mneuhaus/EnragedRabbitProject/usermods/Binky/Images/TCRT5000.jpg

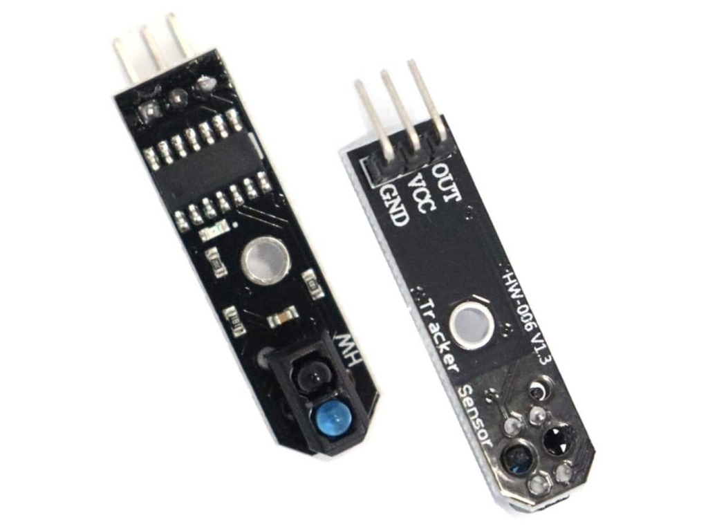
usermods/Binky/Images/TCRT5000.jpg
