mneuhaus/EnragedRabbitProject/usermods/Binky/CAD/EncoderCart - Binky.step

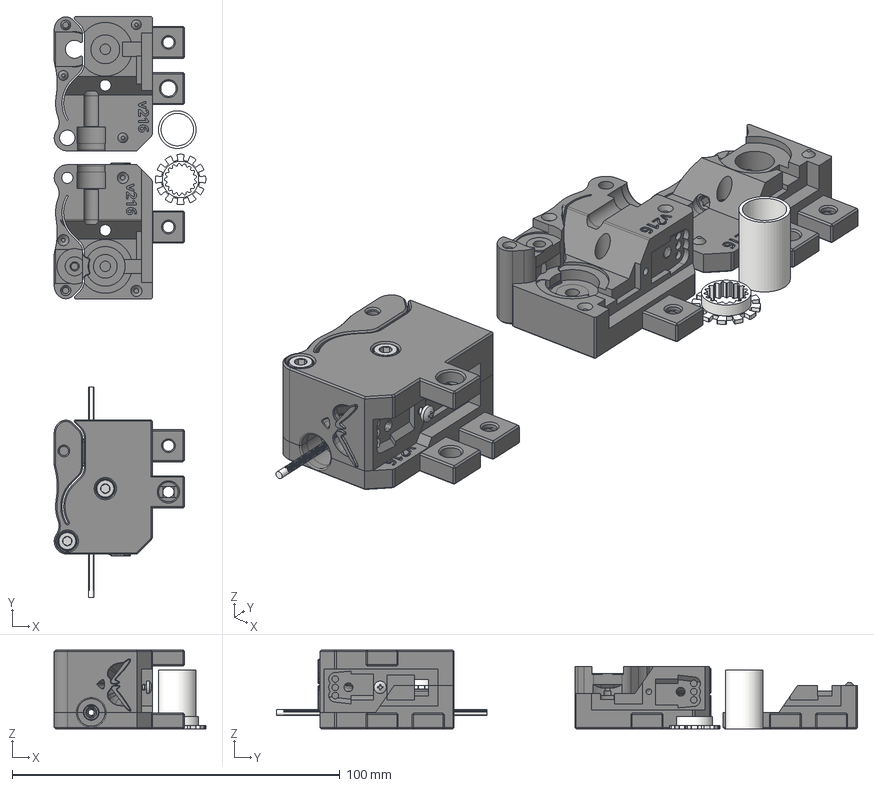
[picture p8: CAD file, 2023-09-06]
usermods/Binky/CAD/EncoderCart - Binky.step
46.2 x 177.2 x 24.0 mm
623ZZ v1
Magnet6x3 v1 (3)
Magnet6x3 v1 (1) (1)
M3x8SHCS v1 (1)
M3x16 SHCS (2)^Fan Assembly (1)_X Carriage (2) (1) x 3
M3 Threaded Insert (1)^VORON Clockwork_X Carriage x 2
stift 3 x 20 (1)^Direct_Drivegear_without_setscrew (1)_Guidler_VORON Clockwork_X Carriage (1)
K3x5x7 Needlebearing (1)^Direct_Drivegear_without_setscrew (1)_Guidle r_VORON Clockwork_X Carriage (1) x 2
Direct_Drivegear_without_setscrew (1)-39^Direct_Drivegear_without_set screw (1)_Guidler_VORON Clockwork_X Carriage (1)
Filament (1)
Encoder_Slotted_Wheel
Screw - 2x10mm - Philips Button Head
Filament
Encoder_Right x 2
Encoder_Left x 2
Encoder_SlottedWheel_PushTool
Encoder_Slotted_Wheel_1
