mneuhaus/EnragedRabbitProject/usermods/Binky/STL/Encoder_Right.stl

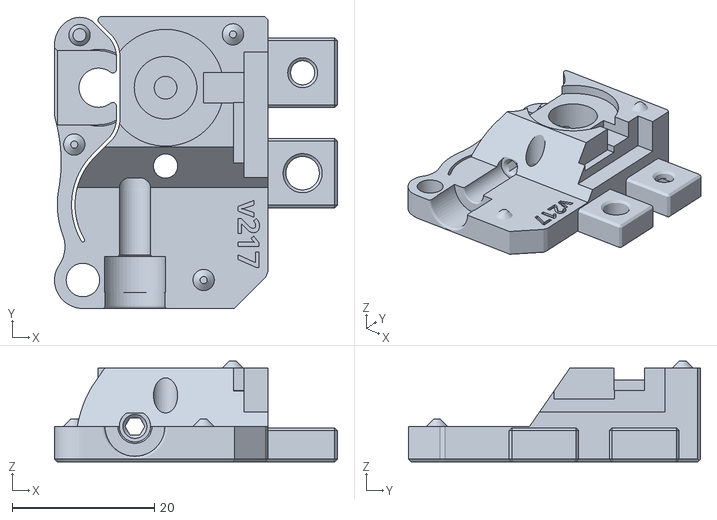
[picture p9: CAD file, 2023-09-24]
usermods/Binky/STL/Encoder_Right.stl
39.8 x 41.0 x 14.2
