mneuhaus/EnragedRabbitProject/usermods/Binky/STL/Encoder_Left.stl

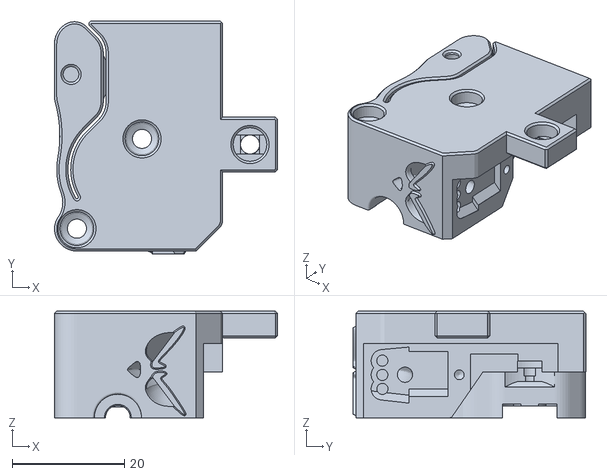
[picture p10: CAD file, 2023-07-21]
usermods/Binky/STL/Encoder_Left.stl
39.8 x 41.5 x 19.0
