mneuhaus/EnragedRabbitProject/usermods/Binky/STL/Encoder_Right_with_magnets.stl

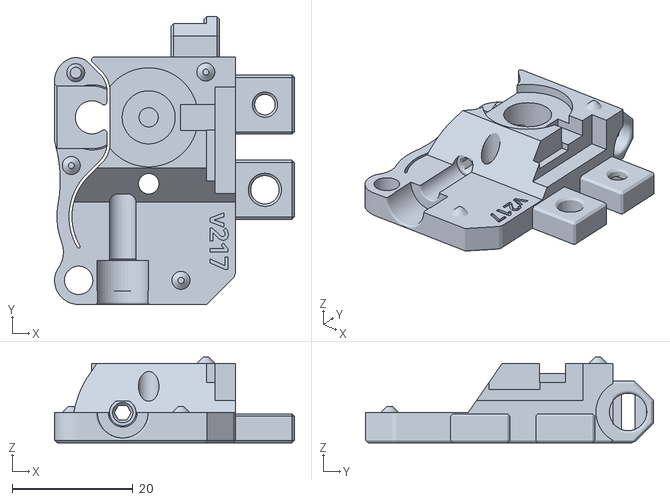
[picture p11: CAD file, 2023-07-21]
usermods/Binky/STL/Encoder_Right_with_magnets.stl
39.8 x 47.7 x 14.2
