mneuhaus/EnragedRabbitProject/usermods/Binky/STL/black_Encoder_Slotted_Wheel.stl

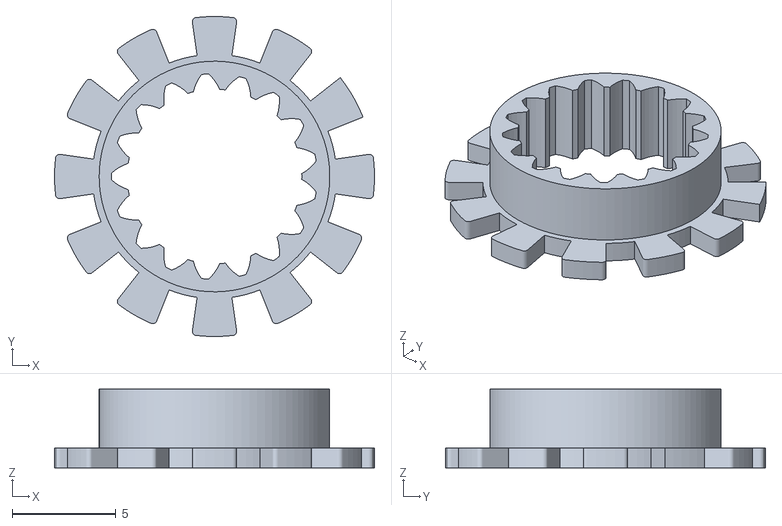
[picture p12: CAD file, 2023-07-21]
usermods/Binky/STL/black_Encoder_Slotted_Wheel.stl
15.4 x 15.4 x 3.80
