mneuhaus/EnragedRabbitProject/usermods/Binky/STL/Tool_Encoder_SlottedWheel_PushTool.stl

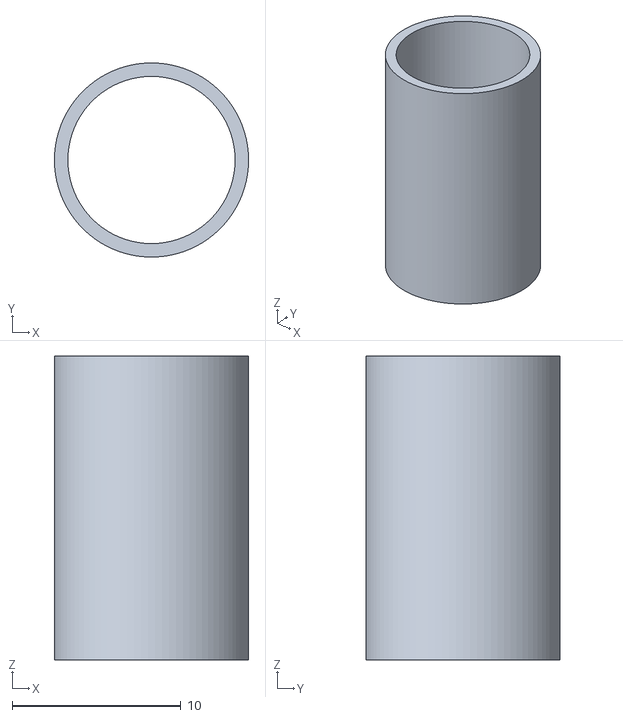
[picture p13: CAD file, 2023-07-21]
usermods/Binky/STL/Tool_Encoder_SlottedWheel_PushTool.stl
11.5 x 11.5 x 18.0
