mneuhaus/EnragedRabbitProject/(list of files, cad)

Other CAD files:
usermods/Binky/CAD/ERCF Binky v1.04.f3z
