mneuhaus/EnragedRabbitProject/(threads)

Thread 1 (2023-02-26):

Encoder is difficult to fine tune and sometimes unreliable

mneuhaus, 2023-02-26:
- [ ] replace tcrt5000 sensor PCB with a custom EE-SX1103 based PCB
- [ ] add a "brake" to prevent the gear to continue spinning when the filament is ejected quickly
- [ ] flare the return path for the filament to guide "kinked" ends of outrunning filament for endless spool mode

mneuhaus, 2023-02-26:
Current progress:

- ERCF Binky PCB v1.0 designed and first batch of 10 ordered (https://a360.co/3EyLsSb)
- Started to create a new version of the modified encoder that will use the new Binky PCB

mneuhaus, 2023-03-12:
PCBs arrived, sadly faulty (my fault) debugging right now

mneuhaus, 2023-03-16:
Second iteration of PCBs are on their way, herer are the current Files for the PCB and matching STL:

- [ERCF Binky - PCB v113_bom.csv](https://github.com/mneuhaus/EnragedRabbitProject/files/10993982/ERCF.Binky.-.PCB.v113_bom.csv)
- [ERCF Binky - PCB v113_cpl.csv
](https://github.com/mneuhaus/EnragedRabbitProject/files/10993983/ERCF.Binky.-.PCB.v113_cpl.csv)
- [ERCF Binky - PCB v115_2023-03-13.zip](https://github.com/mneuhaus/EnragedRabbitProject/files/10993984/ERCF.Binky.-.PCB.v115_2023-03-13.zip)
- [EncoderCart - Binky v121.stl.zip](https://github.com/mneuhaus/EnragedRabbitProject/files/10993987/EncoderCart.-.Binky.v121.stl.zip)

mneuhaus, 2023-04-21:
v145 pushed to git, 9 beta PCBs on their route to the beta testers :)
https://github.com/mneuhaus/EnragedRabbitProject/tree/main/usermods/Binky

Thread 2 (2023-02-26):

FilamentBlock - Magnetic Gate

mneuhaus, 2023-02-26:
sometimes the filament can get through the magnetic gate when the selector passes by a block leading to filament to stick out and create jams in the selector path

mneuhaus, 2023-02-26:
Possible ways to address this:

- [ ] electromaget to only open the gate when the selector has arrived at the specific filament block
- [ ] modify tophat to have 3 servo positions: clamp, unclamp, engage_gear so that the filament would be "clamped" when no servo is pressing on it

moggieuk, 2023-02-27:
I believe that this can be made a non issue by creating just a little friction on the entrance to the gate.  Often a short 2mm ID piece of bowden tube is sufficient but it could also be some kind of mild spring clamp that is released when the servo is moved down.

moggieuk, 2023-02-27:
Another ideas could include a second servo to clamp all gates...

mneuhaus, 2023-02-27:
another servo and/or electro magnetic switch would be kind of a hassle to add onto existing hardware, especiall in regards to Easy Brd, etc.

i like your idea with a tiny bit of fraction, could simply be done with a small "dimple" in the filament path, or as you said a small piece of 2mm inner Diameter tubing

Thread 3 (2023-02-26):

ServoArm tends to wear out

mneuhaus, 2023-02-26:
The ribbed hole for the ServoArm tends to wear out, better would be a design, where an original servo arm is added/emmbedded becaus those nylon won't fail so easily

moggieuk, 2023-02-27:
This one would be a big improvement but would need two variations:
1. MG90S servo
2. Savox Servo

They have different size "arms".   Also there is a really good idea of using a tiny screw to reinforce the "pusher" part of the arm.  Perhaps alignment would be possible to have this strengthening screw also lock the end of the nylon servo arm in place.

mneuhaus, 2023-02-27:
@moggieuk Which Savox exactly would that be?

Yea, either an additional screw or instant glue to fix it in place, since ERCF is outside of the heated chamber the super glue should also hold up decently

moggieuk, 2023-03-18:
Sorry, I wasn't watching.  It's the Savox SH-0255MG.   That model is not discontinued but the replacement has exactly the same footprint.

Thread 5 (2023-02-27):

Purge

mneuhaus, 2023-02-27:

mneuhaus, 2023-03-11:
Design Goals:

- compact Pebble like mechanism from [BigBrain3D.](https://www.bigbrain3d.com/product/retractable-purge-mechanism/), spaghetti tends to cause problems on disposure because of way to much entropy
- powered by a single servo
- must "reach" under the hotend to work for 2.4 and Trident with TAP
- the pebble must be "guided" safely away from the hotend into a chute
- the chute should guide the pebbles into a container outside the regular build room to be emptiable while printing

General concept idea:

An "arm" with multiple layers that will slide into purge position for the hotend to drop its filament into.

Very rough motion test:

https://user-images.githubusercontent.com/316605/224512077-fd6c089a-b5d9-4fcd-8ac8-b1b351b2eea4.mp4

bergyb, 2023-03-31:
What about something like this: [purge with micro](https://www.printables.com/model/291878-purge-tray-with-v24-purge-macro) with changes:
- instead of the purge on the bed, on the 2.4, the purge tower could be on an arm like Klicky probe Dock base
- and then use toolhead to kick the purge tower in a detachable tray under -kick to the left/right or back
- the Dock base could also include Nozzle Scrubber
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

Thread 6 (2023-03-04):

Spool holder

mneuhaus, 2023-03-04:
https://www.youtube.com/watch?v=820pEoL30ok

mneuhaus, 2023-03-19:
Did a simple spool holder mockup to see if the TT DC Motor is capable for the job, yes it is:

https://photos.app.goo.gl/JUA5pxXbdtHy4ghm7

PatrikTheDev, 2023-06-15:
Great idea imo, could eliminate the need for a buffer system. How would you go about synchronising the speed with your unload speed? You can't really control a DC motor with a mosfet without extra diodes and resistors (not an electrical engineer, probably very wrong)

Thread 9 (2023-10-04):

Document error: wrong optical sensor model in the readme file

ntchris, 2023-10-04:
I found that the optical sensor model is wrong in the readme file, which could be misleading to some people,  to waste time and money to buy the very wrong product in order to make their own binky module.

It says it's SX398 in readme file , it has 3 pins on one side (total 5pins, very unusual for a IR sensor, and it's not cheap at all ).
` So instead i created a new PCB based on the same small Omron sensor that is used on the KY-010 board, the EE-SX398. It's tiny, reliable and cheap`

However in the schematic and BOM file it's EE1103, a very different IR sensor, and it's a usual 4pin sensor.
also in the image of etsy, it has 4 pins, so I guess it's indeed 4pins, and silkscreen also says "1103"
[https://github.com/mneuhaus/EnragedRabbitProject/blob/main/usermods/Binky/Images/BinkySchematic.png](url)

https://github.com/mneuhaus/EnragedRabbitProject/tree/main/usermods/Binky#bom

So I guess the readme file is wrong ? it's not SX398 at all ?

Please double check, thanks

ZenMaster1024, 2023-10-10:
Made the mistake of purchasing 10 SX398. Not cool.

Thread 10 (2023-10-23):

Document error: wrong optical sensor pin names in schematic in the readme file

ntchris, 2023-10-23:
Document error: wrong optical sensor pin names in schematic in the readme file

In the readme file we have this picture shows the SX1103's schematic connection for A K EC

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

if we look closely we can see the light emitting diode has E (GND) C (Signal).
which is wrong since the light emitting diode must have VCC and a small resistor and GND.

while the Transistor like symbol must have E and C, and connect to a larger value resistor and GND.

Refer to any regular optical sensor's datasheet,  ie SX1103's.
https://components.omron.com/us-en/sites/components.omron.com.us/files/datasheet_pdf/E526-E1.pdf

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

Please double check.
thanks

mdvorak, 2024-01-02:
That confused me as well, and also in README, there is referenced [EE-SX398](https://github.com/mneuhaus/EnragedRabbitProject/blob/main/usermods/Binky/Readme.md?plain=1#L7), which is completely different sensor (twice in size), which led me to ordering wrong part.

Thread 11 (2024-07-17):

Question: "Rev 0.5" on Aliexpress with no filter IC

k1-801, 2024-07-17:
I am currently trying to purchase a pre-built version of Binky from aliexpress (EU sourcing opeions are not available for my country). I have stumbled upon two different versions of the sensor with two drastically different prices: one labeled as "v1.0.4", that seems to match the design in this repo, and a second one labeled as "rev 0.5", for which there is absolutely no info.

Taking a closer look at the second one, one can notice that the difference is that the filter IC was replaced by something that looks a lot like a transistor (possibly a 3-pin IC, but I doubt it). They seem to be actively trying to hide it, by not showing the side with components on most photos.

Question: how big of a chance that it would work the same?

Here is a sample rev 0.5 link:
https://aliexpress.ru/item/1005006267690351.html

And here is a v1.0.4 for comparison:
https://aliexpress.ru/item/1005006839297860.html
