mneuhaus/EnragedRabbitProject/(commit log)

2023-04-12 Fixed missing whole in Side B
    [EncoderCart - Binky v134.stl, EncoderCart - Binky v135.step, EncoderCart - Binky v140.step, EncoderCart - Binky v140.stl]
2023-04-21 update to v148
    [EncoderCart - Binky v145.dwg, EncoderCart - Binky v145.step, EncoderCart - Binky v145.stl, EncoderCart - Binky v147.stl, EncoderCart - Binky v148.step]
2023-04-21 fix filename
    [EncoderCart - Binky v148.stl]
2023-04-22 moved the magnetHolder up by 0.5mm and moved the version numbers to inside faces
    [ERCF Binky v30.f3z, EncoderCart - Binky v148.step, EncoderCart - Binky v148.stl, EncoderCart - Binky v154.step, EncoderCart - Binky v154.stl]
2023-04-26 v167
    - increase tolerance of slottedWheel sleeve and sensor housing
    - add more alignment cones
    - slightly bulk up perimeter of heated insert hole next to the spring anchor
    [EncoderCart - Binky v154.step, EncoderCart - Binky v154.stl, EncoderCart - Binky v167.stl]
2023-08-28 v217 Step and f3z
    [EncoderCart - Binky.step]
2023-09-06 Release of Binky v1.04 and v217 STLs/STEP
    [ERCF Binky - PCB v1.04_bom.csv, ERCF Binky - PCB v27_bom.csv, ERCF Binky v1.04.f3z, ERCF Binky v30.f3z, EncoderCart - Binky v217.step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]
